Putradika-118/low-power-12b-first-order-delta-sigma-adc/docs/images/DAC_TB.jpeg

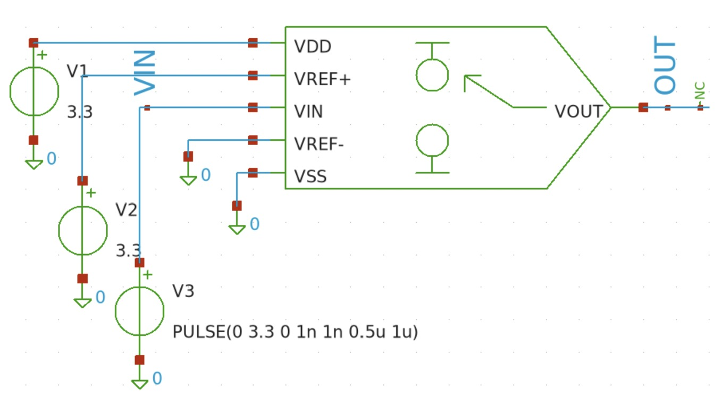
docs/images/DAC_TB.jpeg
