Putradika-118/low-power-12b-first-order-delta-sigma-adc/src/layout/integrator_first_order/lvs/integrator.spice

** sch_path: /foss/designs/low-power-12b-first-order-delta-sigma-adc/src/schematics/integrator_first_order/integrator.sch
.subckt integrator Vin+ Vin- clk1 clk2
*.PININFO Vin+:I Vin-:I clk1:I clk2:I
XM1 net1 clk2 OUT_DAC_PLUS VSS nfet_03v3 L=0.3u W=1u nf=1 ad='int((nf+1)/2) * W/nf * 0.18u' as='int((nf+2)/2) * W/nf * 0.18u' pd='2*int((nf+1)/2) * (W/nf + 0.18u)'
+ ps='2*int((nf+2)/2) * (W/nf + 0.18u)' nrd='0.18u / W' nrs='0.18u / W' sa=0 sb=0 sd=0
XM2 net2 clk1 VSS VSS nfet_03v3 L=0.3u W=1u nf=1 ad='int((nf+1)/2) * W/nf * 0.18u' as='int((nf+2)/2) * W/nf * 0.18u' pd='2*int((nf+1)/2) * (W/nf + 0.18u)'
+ ps='2*int((nf+2)/2) * (W/nf + 0.18u)' nrd='0.18u / W' nrs='0.18u / W' sa=0 sb=0 sd=0
XM3 Vin+ clk1 net1 VSS nfet_03v3 L=0.3u W=1u nf=1 ad='int((nf+1)/2) * W/nf * 0.18u' as='int((nf+2)/2) * W/nf * 0.18u' pd='2*int((nf+1)/2) * (W/nf + 0.18u)'
+ ps='2*int((nf+2)/2) * (W/nf + 0.18u)' nrd='0.18u / W' nrs='0.18u / W' sa=0 sb=0 sd=0
XM4 net2 clk2 VOUTP_INT VSS nfet_03v3 L=0.3u W=1u nf=1 ad='int((nf+1)/2) * W/nf * 0.18u' as='int((nf+2)/2) * W/nf * 0.18u' pd='2*int((nf+1)/2) * (W/nf + 0.18u)'
+ ps='2*int((nf+2)/2) * (W/nf + 0.18u)' nrd='0.18u / W' nrs='0.18u / W' sa=0 sb=0 sd=0
XM5 net3 clk2 OUT_DAC_MIN VSS nfet_03v3 L=0.3u W=1u nf=1 ad='int((nf+1)/2) * W/nf * 0.18u' as='int((nf+2)/2) * W/nf * 0.18u' pd='2*int((nf+1)/2) * (W/nf + 0.18u)'
+ ps='2*int((nf+2)/2) * (W/nf + 0.18u)' nrd='0.18u / W' nrs='0.18u / W' sa=0 sb=0 sd=0
XM6 net4 clk1 VSS VSS nfet_03v3 L=0.3u W=1u nf=1 ad='int((nf+1)/2) * W/nf * 0.18u' as='int((nf+2)/2) * W/nf * 0.18u' pd='2*int((nf+1)/2) * (W/nf + 0.18u)'
+ ps='2*int((nf+2)/2) * (W/nf + 0.18u)' nrd='0.18u / W' nrs='0.18u / W' sa=0 sb=0 sd=0
XM7 Vin- clk1 net3 VSS nfet_03v3 L=0.3u W=1u nf=1 ad='int((nf+1)/2) * W/nf * 0.18u' as='int((nf+2)/2) * W/nf * 0.18u' pd='2*int((nf+1)/2) * (W/nf + 0.18u)'
+ ps='2*int((nf+2)/2) * (W/nf + 0.18u)' nrd='0.18u / W' nrs='0.18u / W' sa=0 sb=0 sd=0
XM8 net4 clk2 VOUTM_INT VSS nfet_03v3 L=0.3u W=1u nf=1 ad='int((nf+1)/2) * W/nf * 0.18u' as='int((nf+2)/2) * W/nf * 0.18u' pd='2*int((nf+1)/2) * (W/nf + 0.18u)'
+ ps='2*int((nf+2)/2) * (W/nf + 0.18u)' nrd='0.18u / W' nrs='0.18u / W' sa=0 sb=0 sd=0
* noconn OUT_DAC_PLUS
* noconn OUT_DAC_MIN
XC1 net1 net2 cap_mim_2f0fF c_width=10e-6 c_length=10e-6
XC3 net3 net4 cap_mim_2f0fF c_width=10e-6 c_length=10e-6
.ends
