Putradika-118/low-power-12b-first-order-delta-sigma-adc/(commit log)

2026-06-30 feat diffamp schematic
    [fullydiffamp.sch, fullydiffamp_tb.sch]
2026-06-30 feat test
    [fullydiffamp_tb.sch]
2026-06-30 Feat add comparator and DAC
    [DAC_1_BIT.sch, DAC_1_BIT_TB.sch, comparator.sch]
2026-06-30 Feat add filter decimation
2026-06-30 Feat change tb diff amp
    [fullydiffamp_tb.sch]
2026-07-01 Feat Renamed the Block Component Folders
    Renamed the Block Component Folders
    [DAC_1_BIT.sch, DAC_1_BIT_TB.sch, fullydiffamp.sch, fullydiffamp_tb.sch, integrator.sch]
2026-07-04 Feat sizing integrator
    Integrator sizing with W/L=25 and added test signal
    [integrator.sch]
2026-07-04 Fix: Sizing Comparator Schematic
    [COMPARATOR_SD.sch, COMP_TB.sch]
2026-07-05 Feat Update Schematic of DAC
    Revision of Size
    [DAC_1_BIT.sch, DAC_1_BIT_TB.sch]
2026-07-18 feat add simulation review
    [fullydiffamp.sch, fullydiffamp_tb_ac.sch, fullydiffamp_tb_tran.sch]
2026-07-18 Feat -Update Comparator
    [COMPARATOR_SD.sch, COMP_TB.sch]
2026-07-18 Remove: Out Of folder diffamp
    [fullydiffamp.sch]
2026-07-18 -Feat Update Integrated Simulation Comparator & DAC
    [COMPARATOR_SD.sch, COMP_TB.sch, integrated_comparator_dac.sch]
2026-07-18 Feat add temporary folder
    [analog_integration.sch, diffamp_integ_integration_tran_tb.sch]
2026-07-19 feat add new simulation review
    [fullydiffamp.sch, fullydiffamp_tb_ac.sch, fullydiffamp_tb_tran.sch]
2026-07-19 - Update Block Diagram, Integration DAC, Comp
    [COMPARATOR_SD.sch, DAC_1_BIT.sch, DAC_1_BIT_TB.sch, integrated_comparator_dac.sch]
2026-07-22 refactor: changing folder name & add xschemrc
    [COMPARATOR_SD.sch, COMP_TB.sch, DAC_1_BIT.sch, DAC_1_BIT_TB.sch, analog_integration.sch, diffamp_integ_integration_tran_tb.sch, fullydiffamp.sch, fullydiffamp_tb_ac.sch]
2026-07-22 feat add symbol back
    [analog_integration_tb.sch, diffamp_integ_integration.sch, integrated_comparator_dac.sch]
2026-08-15 Update Sch Diffamp
    Re-Size to Match Minimum in Klayout
    [fullydiffamp_tb_ac_sine.sch, fullydiffamp_tb_tran_pulse.sch, fullydiffamp_tb_tran_sine.sch, fullydiffamp_tb_tran_triangular.sch]
2026-08-15 Create Diffamp TEST DRIVE to 5pF
    [fullydiffamp_tb_tran_sine_TEST_DRIVE.sch]
2026-08-15 Feat: Added analog_integration_v11
    [analog_integration_v11.sch]
2026-08-17 Add integrator layout, filter decimation layout, and clock processing layout
2026-08-20 feat add refined integrator layout
    [integrator.sch]
2026-08-21 feat add integrator lvs result
    [integrator.sch]
2026-08-22 change filter decimation layout
2026-08-22 Feat: Update info.yaml (add pin list)
    -Add pin to the input.yaml file
